flksgrd/IOT_FinalProject/Overleaf/sections/Conclusion.tex

\ifdefined\mainfile\else
\documentclass{article}
\usepackage{graphicx}
\usepackage{float}
\usepackage{amsmath}
\usepackage{amssymb}
\usepackage[a4paper, left=2.5cm, right=2.5cm, top=2.5cm, bottom=2.5cm]{geometry}
\usepackage[colorlinks=true,linkcolor=black,citecolor=blue,urlcolor=blue]{hyperref}

\begin{document}
\fi

\section{Conclusion}
\label{sec:Conclusion}

This project successfully implemented a complete IoT system that fulfills all specified project requirements. WiFi communication, sensing, actuation, and backend visualization were integrated into a working solution. All mandatory deliverables were completed, including demonstration and documentation within the required page limit. A detailed contribution breakdown is provided in the appendix.

\begin{table}[H]
    \centering
    \begin{tabular}{l | c}
       \textbf{Reqierment}  & fufiled \\ \hline
        Use WIFI communication & \checkmark \\
        Minimum 1 Analog sensor, one digital sensor and one form of actuation & \checkmark \\
        Backend/visualization & \checkmark \\
        Poster pitch and demo to the class & \checkmark \\
        Repot max 10 pages & \checkmark
    \end{tabular}
    \caption{Checklist of project reqierments}
    \label{tab:tjeklist}
\end{table}

\end{document}
