flksgrd/IOT_FinalProject/Overleaf/sections/communication-technologies.tex

\ifdefined\mainfile\else
\documentclass{article}
\usepackage{graphicx}
\usepackage{float}
\usepackage{amsmath}
\usepackage{amssymb}
\usepackage[a4paper, left=2.5cm, right=2.5cm, top=2.5cm, bottom=2.5cm]{geometry}
\usepackage[colorlinks=true,linkcolor=black,citecolor=blue,urlcolor=blue]{hyperref}
\begin{document}
\fi

\section{Technical design}
\label{sec:comms}
\subsection{Technical Overview}
The system is built around an ESP8266 microcontroller, which serves as the central control unit for sensing, processing, and communication. The smart bin is equipped with sensors to monitor the fill level of the trash as well as environmental conditions, enabling the system to operate automatically and efficiently.\\
An embedded control system manages the different operational states of the bin, including monitoring, sealing, and standby modes. A full block digram of the system can be seen in Figure \ref{fig:hardware_block_diagram}
\begin{figure}[H]
    \centering
    
    \caption{System Block diagram}
    \label{fig:hardware_block_diagram}
\end{figure}

\subsection{Control System}
The control logic of the system is implemented as a state machine managed by the ESP8266. This approach ensures structured and predictable behavior across different operating conditions.\\
The system operates in four main states: \textit{LOAD}, \textit{CHECK}, \textit{CLOSE}, and \textit{EMPTY\_ME}. Each state defines a specific phase of the system’s operation.\\
In the \textit{LOAD} state, the system waits for the user to position the trash bag and press a button to initialize the process. Once the button is pressed, the system prepares the bag for normal operation and transitions to the next state.\\
In the \textit{CHECK} state, the system periodically measures the fill level of the trash bin at fixed time intervals of 15 minutes. Based on these measurements, the system determines whether the bin has reached a predefined threshold of 8cm or less.\\
When this threshold is reached, the system transitions to the \textit{CLOSE} state. In this state, the closing mechanism is activated to seal the trash bag.\\
After the bag has been sealed, the system transitions to the \textit{EMPTY\_ME} state. In this final state, the system waits for user input before preparing the bin for emptying and resetting the system for the next cycle.
\begin{figure}[H]
\centering
\resizebox{0.7\textwidth}{!}{
\begin{circuitikz}
\tikzstyle{every node}=[font=\fontsize{18.2pt}{23.7pt}\selectfont]

% Definer de 4 states
\draw  (7,25) circle (1.875cm) node[ inner xsep=0.080cm, inner ysep=0.085cm, rounded corners=0.020cm] {\fontsize{19.9pt}{25.9pt}\selectfont Load} ;
\draw  (16,25) circle (1.875cm) node[ inner xsep=0.080cm, inner ysep=0.085cm, rounded corners=0.020cm] {\fontsize{19.9pt}{25.9pt}\selectfont Check} ;
\draw  (16,16) circle (1.875cm) node[ inner xsep=0.080cm, inner ysep=0.085cm, rounded corners=0.020cm] {\fontsize{19.9pt}{25.9pt}\selectfont Close} ;
\draw  (7,16) circle (1.875cm) node[ inner xsep=0.080cm, inner ysep=0.085cm, rounded corners=0.020cm] {\fontsize{19.9pt}{25.9pt}\selectfont EmptyMe} ;

% Pile og betingelser (Transitions)
% Load -> Check
\draw [-{Stealth[scale=1.5]}, ] (8.875,25) -- (14.125,25) 
    node[pos=0.5, fill={rgb,255:red,255; green,255; blue,255}, fill opacity=1, text opacity=1, inner xsep=0.080cm, inner ysep=0.085cm, rounded corners=0.020cm] {Button = HIGH};

% Check -> Close
\draw [-{Stealth[scale=1.5]}, ] (16,23.125) -- (16,17.875) 
    node[pos=0.5, fill={rgb,255:red,255; green,255; blue,255}, fill opacity=1, text opacity=1, inner xsep=0.080cm, inner ysep=0.085cm, rounded corners=0.020cm] {Distance $\le$ 8 cm};

% Close -> EmptyMe
\draw [-{Stealth[scale=1.5]}, ] (14.125,16) -- (8.875,16) 
    node[pos=0.5, fill={rgb,255:red,255; green,255; blue,255}, fill opacity=1, text opacity=1, inner xsep=0.080cm, inner ysep=0.085cm, rounded corners=0.020cm] {Motors done};

% EmptyMe -> Load
\draw [-{Stealth[scale=1.5]}, ] (7,17.875) -- (7,23.125) 
    node[pos=0.5, fill={rgb,255:red,255; green,255; blue,255}, fill opacity=1, text opacity=1, inner xsep=0.080cm, inner ysep=0.085cm, rounded corners=0.020cm] {Button = HIGH};

\end{circuitikz}
}
\caption{State machine diagram for the smart trash bin}
\label{fig:state-diagram}
\end{figure}

\subsection{Mechanical Design}
The mechanical components of the system are based on a custom-designed 3D model of the trash bin.
The closing mechanism works by using two stepper motors to rotate two rollers with three O-rings on each. This mechanism pulls and releases the strings of the trash bag.
When activated, the motors rotate the rollers, and the friction between the O-rings and the strings pulls the strings in and closes the bag. The direction of rotation can also be reversed to loosen the strings when the trash bag needs to be removed.
The design keeps the closing/releasing mechanism compact while still allowing the rollers and motors to be aligned. Furthermore, the custom 3D construction allows for precise tolerances between the rollers and the stepper motors.
The 3D design also features a lid with mounting points and cutouts for attaching the ultrasonic sensor and the button used to control the embedded system. 
Figure \ref{fig:cad_design} shows an exploded view of the 3D CAD model.

\begin{figure}[H]
    \centering
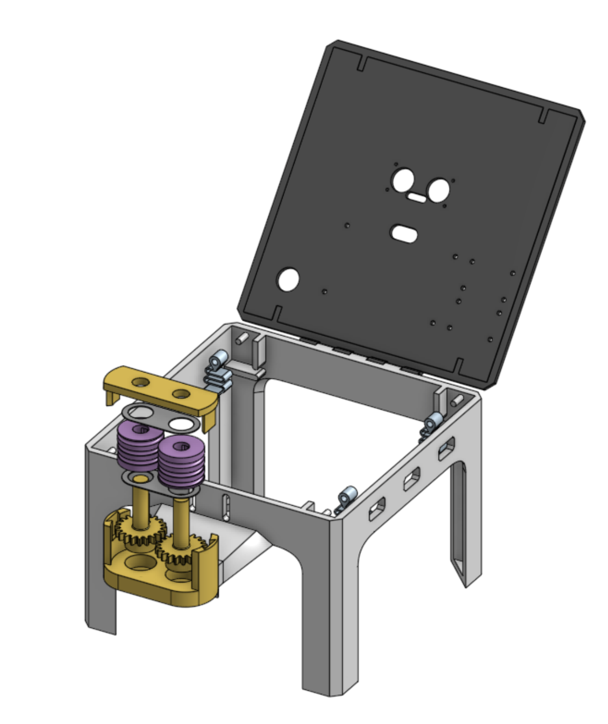
[picture p9: Overleaf/images/screenshots/Cad_model.png]
    
    \caption{3D CAD design of the trash bin}
    \label{fig:cad_design}
\end{figure}

\subsection{Communication and Notifications
}
The ESP connects to the local WiFi network and pushes all its data to ThingSpeak over HTTP. On the notification side we use IFTTT(IF This Then That: two ThingSpeak React rules watch field 4 (bag-full flag) and field 2 (bags remaining) and fire a push notification to the user's phone when the bag is full or when the stock drops below three. Setup is minimal — the user installs the IFTTT app, connects the ThingSpeak service once, and from then on gets notified without having to check the dashboard. It is not a sophisticated solution, but for a prototype it means the bin can actually reach the user when they are in another room

\ifdefined\mainfile\else
\end{document}
\fi
