flksgrd/IOT_FinalProject/Overleaf/sections/data-presentation.tex

\ifdefined\mainfile\else
\documentclass{article}
\usepackage{graphicx}
\usepackage{float}
\usepackage{amsmath}
\usepackage{amssymb}
\usepackage[a4paper, left=2.5cm, right=2.5cm, top=2.5cm, bottom=2.5cm]{geometry}
\usepackage[colorlinks=true,linkcolor=black,citecolor=blue,urlcolor=blue]{hyperref}
\begin{document}
\fi

\section{How we present data to the user}
\label{sec:presentation}

The user sees the bin's status through three surfaces, each chosen for a different context. The primary one is the web dashboard at \url{https://dtutrash.netlify.app/} -- a single page with four large cards (\emph{Bags remaining}, \emph{Distance}, \emph{State} and \emph{Temperature}) that auto-refreshes every 5 seconds, plus an input box for remotely setting the bag inventory. Writing to that input pushes the new count to ThingSpeak field 5; the ESP polls field 5 within 30\,s, copies it into its internal counter, and confirms by writing the value back on field 2, which the dashboard then picks up. Worst-case round-trip is roughly $30 + 16 + 5 = 51$ s, which we communicate to the user with a toast that says \emph{"Set to X bags -- ESP fetches in $<$30\,s"}.
\\ \\
Two small details on the dashboard needed smart ways to do. The first is the ONLINE/OFFLINE pill in the top-right corner: ThingSpeak will happily serve cached data even when the ESP is unplugged, so HTTP success says nothing about whether the bin is alive. The pill instead checks the age of the latest ESP reading and flips to OFFLINE if it is older than 90\,s. 
\\ \\
The second surface is the on-device OLED display. The SSD1306 on the lid shows the current FSM state in plain English (\textsc{Ready}, \textsc{Checking}, \textsc{Closing bag}, \textsc{Replace bag}). It is the channel for moments when the user is standing at the bin and does not want to pull out their phone.
\\ \\
The third surface is push notifications, delivered via IFTTT and triggered by a ThingSpeak React rule: \emph{Trash bag is full -- please replace it} fires on \texttt{field4 = 1}, and \emph{Running low on trash bags} fires on \texttt{field2 $<$ 3}. IFTTT is a good fit for a tinkering project like ours, but a polished product would ship its own app so everything lives in one place.

\ifdefined\mainfile\else
\end{document}
\fi
