flksgrd/IOT_FinalProject/Overleaf/appendix-sections/figures.tex

\ifdefined\mainfile\else
\documentclass{article}
\usepackage{circuitikz}
\usepackage{graphicx}
\usepackage{float}
\usepackage[a4paper, left=2.5cm, right=2.5cm, top=2.5cm, bottom=2.5cm]{geometry}
\usepackage[colorlinks=true,linkcolor=black,citecolor=blue,urlcolor=blue]{hyperref}
\begin{document}
\fi

\section{Larger figures}
\label{sec:appendix-figures}

This appendix reproduces the report's main figures at a larger size for readability, and collects screenshots of the cloud-side configuration so the setup is reproducible.

% ------------------------------------------------------------------
% Helper for "screenshot pending" boxes -- replace each block with
% a real \includegraphics{...} once the screenshot has been added
% to Overleaf/images/screenshots/.
% ------------------------------------------------------------------
\newcommand{\tbdimg}[2]{%
    \fbox{\parbox[c][6cm][c]{0.9\textwidth}{\centering\itshape TODO: add screenshot -- #1\\[2pt]\small(save to \texttt{images/screenshots/#2})}}%
}

\subsection*{Device-side state machine}

\begin{figure}[H]
\centering
\resizebox{1\textwidth}{!}{
\begin{circuitikz}
\tikzstyle{every node}=[font=\fontsize{18.2pt}{23.7pt}\selectfont]

% Definer de 4 states
\draw  (7,25) circle (1.875cm) node[ inner xsep=0.080cm, inner ysep=0.085cm, rounded corners=0.020cm] {\fontsize{19.9pt}{25.9pt}\selectfont Load} ;
\draw  (16,25) circle (1.875cm) node[ inner xsep=0.080cm, inner ysep=0.085cm, rounded corners=0.020cm] {\fontsize{19.9pt}{25.9pt}\selectfont Check} ;
\draw  (16,16) circle (1.875cm) node[ inner xsep=0.080cm, inner ysep=0.085cm, rounded corners=0.020cm] {\fontsize{19.9pt}{25.9pt}\selectfont Close} ;
\draw  (7,16) circle (1.875cm) node[ inner xsep=0.080cm, inner ysep=0.085cm, rounded corners=0.020cm] {\fontsize{19.9pt}{25.9pt}\selectfont EmptyMe} ;

% Pile og betingelser (Transitions)
% Load -> Check
\draw [-{Stealth[scale=1.5]}, ] (8.875,25) -- (14.125,25)
    node[pos=0.5, fill={rgb,255:red,255; green,255; blue,255}, fill opacity=1, text opacity=1, inner xsep=0.080cm, inner ysep=0.085cm, rounded corners=0.020cm] {Button = HIGH};

% Check -> Close
\draw [-{Stealth[scale=1.5]}, ] (16,23.125) -- (16,17.875)
    node[pos=0.5, fill={rgb,255:red,255; green,255; blue,255}, fill opacity=1, text opacity=1, inner xsep=0.080cm, inner ysep=0.085cm, rounded corners=0.020cm] {Distance $\le$ 8 cm};

% Close -> EmptyMe
\draw [-{Stealth[scale=1.5]}, ] (14.125,16) -- (8.875,16)
    node[pos=0.5, fill={rgb,255:red,255; green,255; blue,255}, fill opacity=1, text opacity=1, inner xsep=0.080cm, inner ysep=0.085cm, rounded corners=0.020cm] {Motors done)};

% EmptyMe -> Load
\draw [-{Stealth[scale=1.5]}, ] (7,17.875) -- (7,23.125)
    node[pos=0.5, fill={rgb,255:red,255; green,255; blue,255}, fill opacity=1, text opacity=1, inner xsep=0.080cm, inner ysep=0.085cm, rounded corners=0.020cm] {Button = HIGH};

\end{circuitikz}
}
\caption{State machine diagram for the smart trash can}
\label{fig:state-diagram}
\end{figure}

% ------------------------------------------------------------------
\subsection*{Web dashboard}

\begin{figure}[H]
    \centering
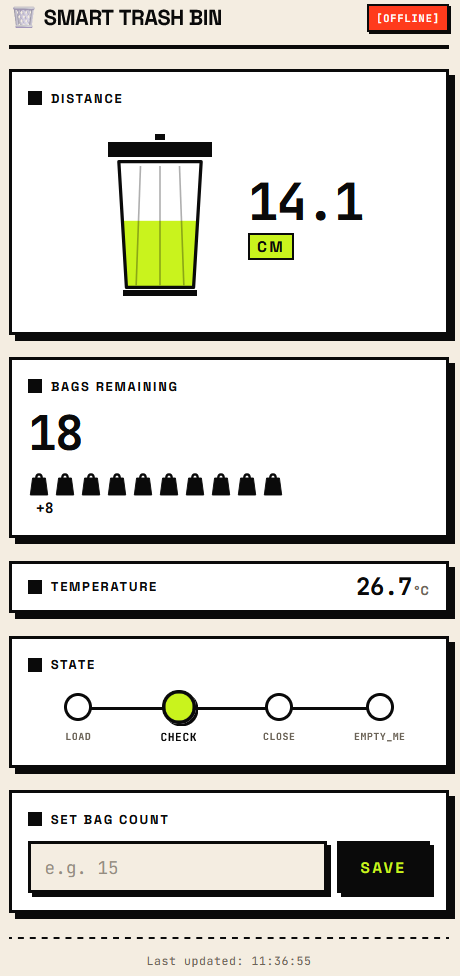
[picture p10: Overleaf/images/screenshots/dashboard_main.png]
    
    \caption{Web dashboard hosted on Netlify -- live view of distance, bags remaining, temperature and FSM state, with the OFFLINE pill in the top-right corner. The "Set bag count" input writes to ThingSpeak field 5, which the ESP picks up on its next 30\,s poll.}
    \label{fig:dashboard-main}
\end{figure}

% ------------------------------------------------------------------
\subsection*{ThingSpeak channel}

\begin{figure}[H]
    \centering
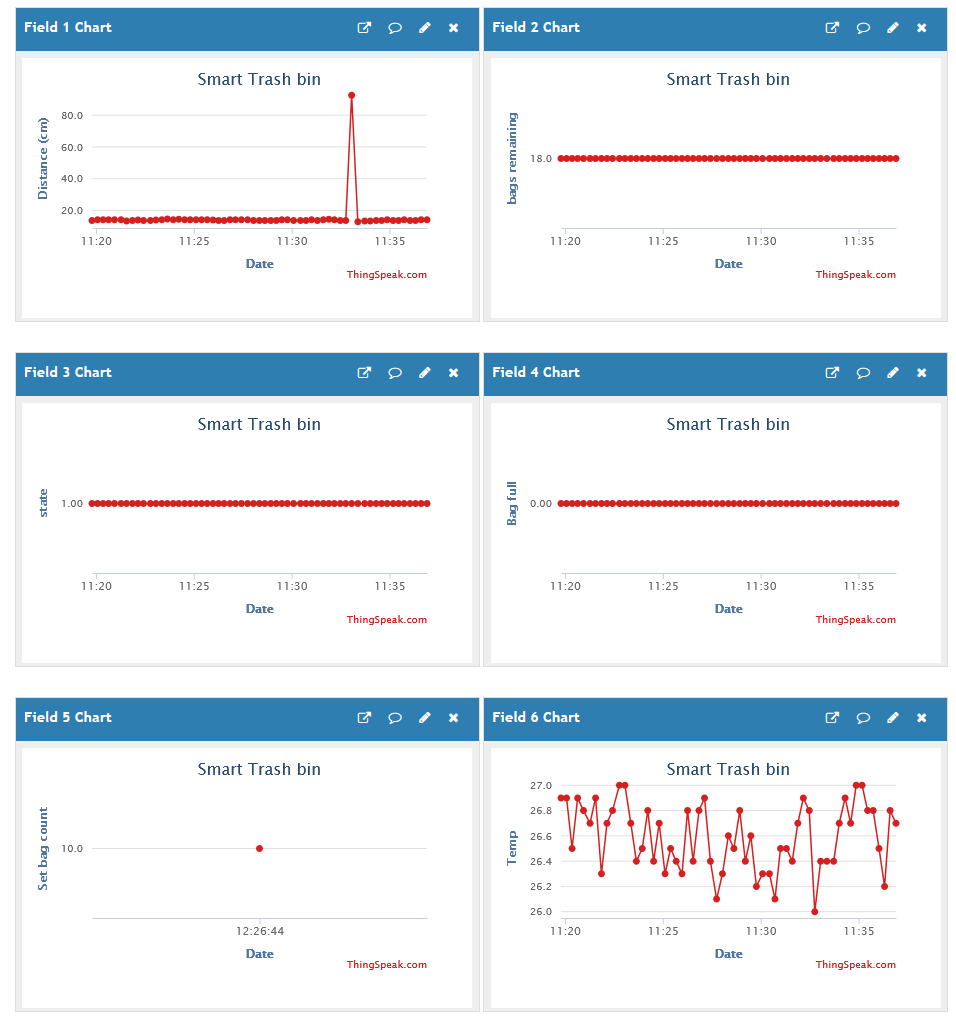
[picture p11: Overleaf/images/screenshots/thingspeak_channel.png]
    
    \caption{ThingSpeak channel 3364403. Field 1 plots distance in cm, field 2 the bag inventory, field 3 the FSM state, field 4 the bag-full event flag, field 5 the dashboard's set-bag-count commands and field 6 the LM35 temperature reading.}
    \label{fig:thingspeak-channel}
\end{figure}

\subsection*{Phone Notifications}

\begin{figure}[H]
    \centering
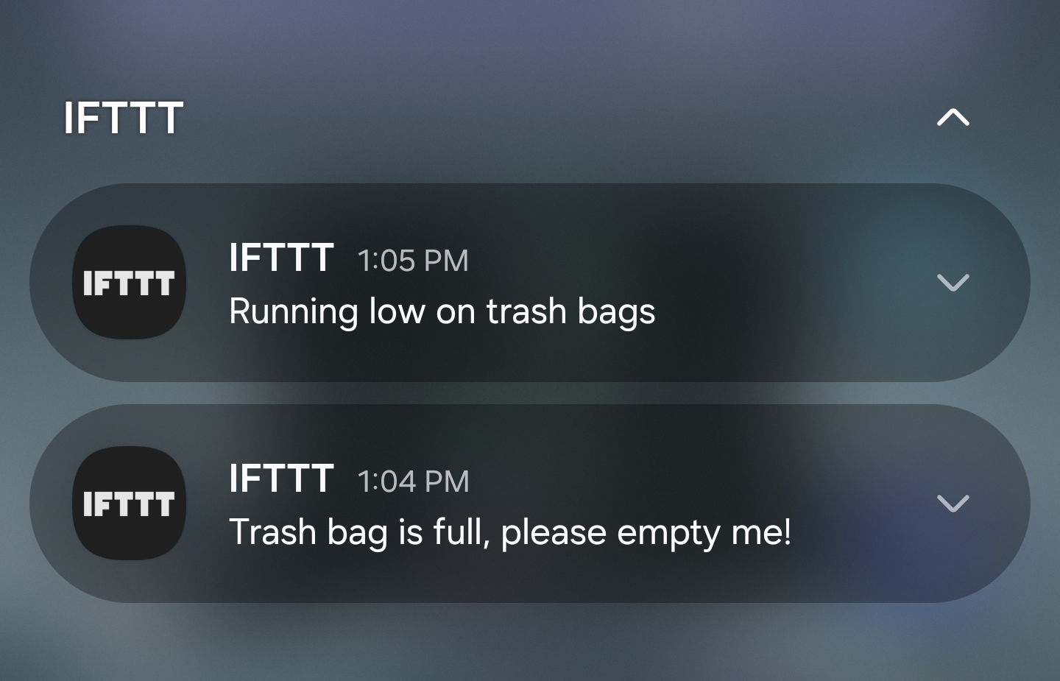
[picture p12: Overleaf/images/screenshots/phone_notification.png]
     
    \caption{Push notification as it arrives on the user's phone (sent by IFTTT in response to a ThingSpeak React rule).}
    \label{fig:phone-notification}
\end{figure}

% ------------------------------------------------------------------
\subsection*{Working prototype}

\begin{figure}[H]
    \centering
    
    \caption{The fully assembled Smart Trash Bin.}
    \label{fig:bin-assembled}
\end{figure}
\ifdefined\mainfile\else
\end{document}
\fi
