flksgrd/IOT_FinalProject/Overleaf/appendix-sections/group-contract.tex

\ifdefined\mainfile\else
\documentclass{article}
\usepackage{graphicx}
\usepackage{float}
\usepackage[a4paper, left=2.5cm, right=2.5cm, top=2.5cm, bottom=2.5cm]{geometry}
\usepackage[colorlinks=true,linkcolor=black,citecolor=blue,urlcolor=blue]{hyperref}
\begin{document}
\fi

\section{Group contract}
\label{sec:appendix-group-contract}

The group contract was filled in and signed by all six members in Session~1 (26 March 2026). The signed document is uploaded to DTU LEARN alongside this appendix as a separate file.

\begin{figure}[H]
    \centering
    
\end{figure}

\begin{figure}[H]
    \centering
    
\end{figure}

\begin{figure}[H]
    \centering
    
\end{figure}

\ifdefined\mainfile\else
\end{document}
\fi
