flksgrd/IOT_FinalProject/Overleaf/appendix-sections/who-did-what.tex

\ifdefined\mainfile\else
\documentclass{article}
\usepackage{graphicx}
\usepackage{float}
\usepackage[a4paper, left=2.5cm, right=2.5cm, top=2.5cm, bottom=2.5cm]{geometry}
\usepackage[colorlinks=true,linkcolor=black,citecolor=blue,urlcolor=blue]{hyperref}
\begin{document}
\fi

\section{Who did what}
\label{sec:appendix-who}

The table below summarises module ownership during the project. The "share" column gives an approximate percentage distribution of effort per group member across the project as a whole, estimated jointly by the group at the end of the project. The total sums to 100\%.

\begin{table}[H]
    \centering
    \begin{tabular}{l|l|l}
        \textbf{Module} & \textbf{Owner(s)} & \textbf{Notes} \\
        \hline
        Mechanical / CAD design                  & Sigurd, Tobias, Anders              & 3D-printed prototypes \\
        
        Motor + sensor integration               & Jonas, Tobias, Andreas, Sigurd      & ULN2003, HC-SR04 \\
        Firmware (state machine, ESP8266)        & Mads, Tobias, Andreas, Jonas                        & \texttt{sketch\_apr16a.ino} \\
        ThingSpeak + IFTTT integration           & Mads, Sigurd                        & React rules, applets \\
        Web dashboard                            & Mads, Sigurd                      & \texttt{docs/index.html} \\
        OLED + LM35 (display, temperature)       & Anders, Tobias, Andreas, Jonas                      & SSD1306 I\textsuperscript{2}C, IIR filter \\
        Report                                   & All                         & \\
    \end{tabular}
    \caption{Module ownership}
    \label{tab:modulansvar}
\end{table}

\begin{table}[H]
    \centering
    \begin{tabular}{l|c|c}
        \textbf{Name} & \textbf{Student no.} & \textbf{Share of effort} \\
        \hline
        Anders Falkesgaard            & s245905 & 17\% \\
        Andreas Jacobsen              & s241123 & 17\% \\
        Jonas Beck Jensen             & s240324 & 16\% \\
        Mads Rudolph                  & s246132 & 17\% \\
        Sigurd Hestbech Christiansen  & s245534 & 17\% \\
        Tobias Nilsson                & s233987 & 16\% \\
        \hline
        \textbf{Total}                &         & \textbf{100\%}\\
    \end{tabular}
    \caption{Approximate percentage distribution of effort per group member}
    \label{tab:tidsforbrug}
\end{table}

\ifdefined\mainfile\else
\end{document}
\fi
