flksgrd/IOT_FinalProject/MATLAB/battery_life.png

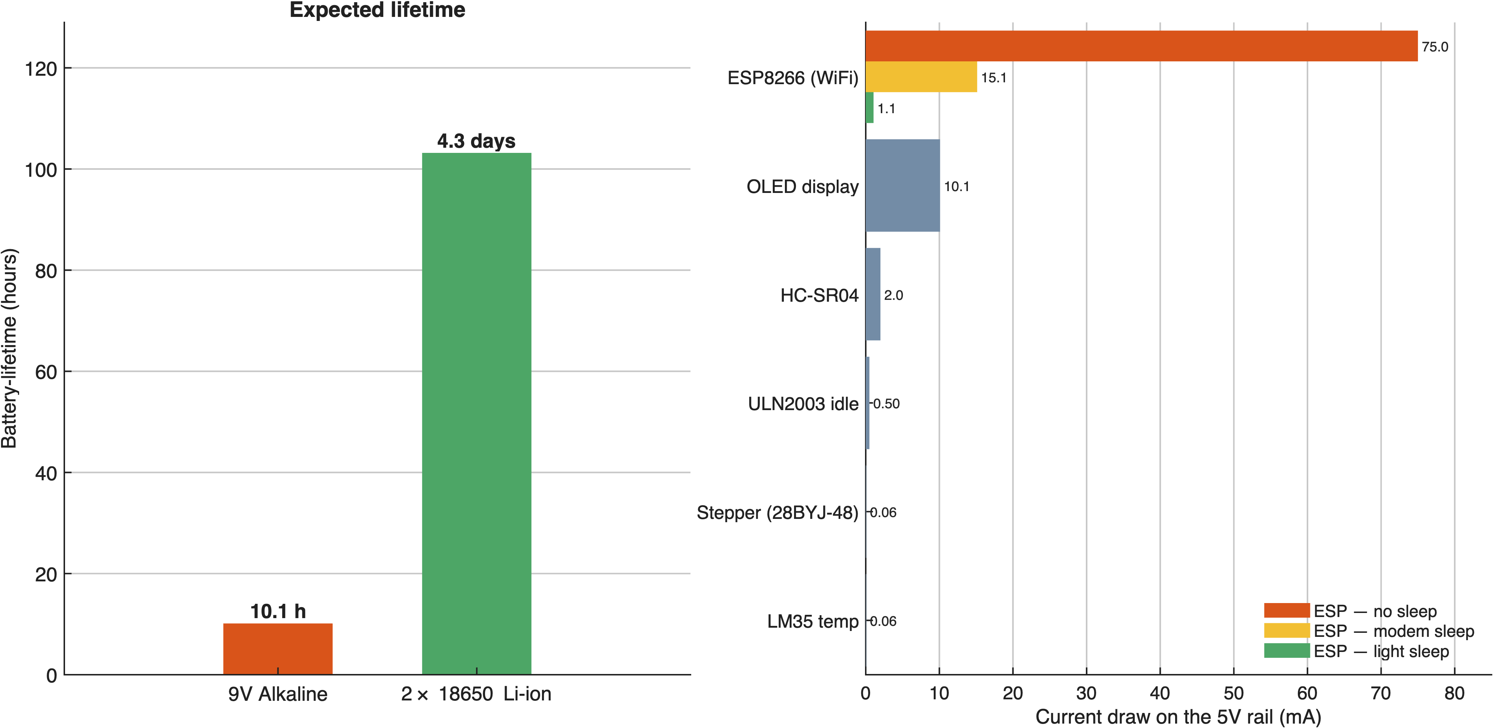
MATLAB/battery_life.png
