flksgrd/IOT_FinalProject/MATLAB/whatif_deepsleep.png

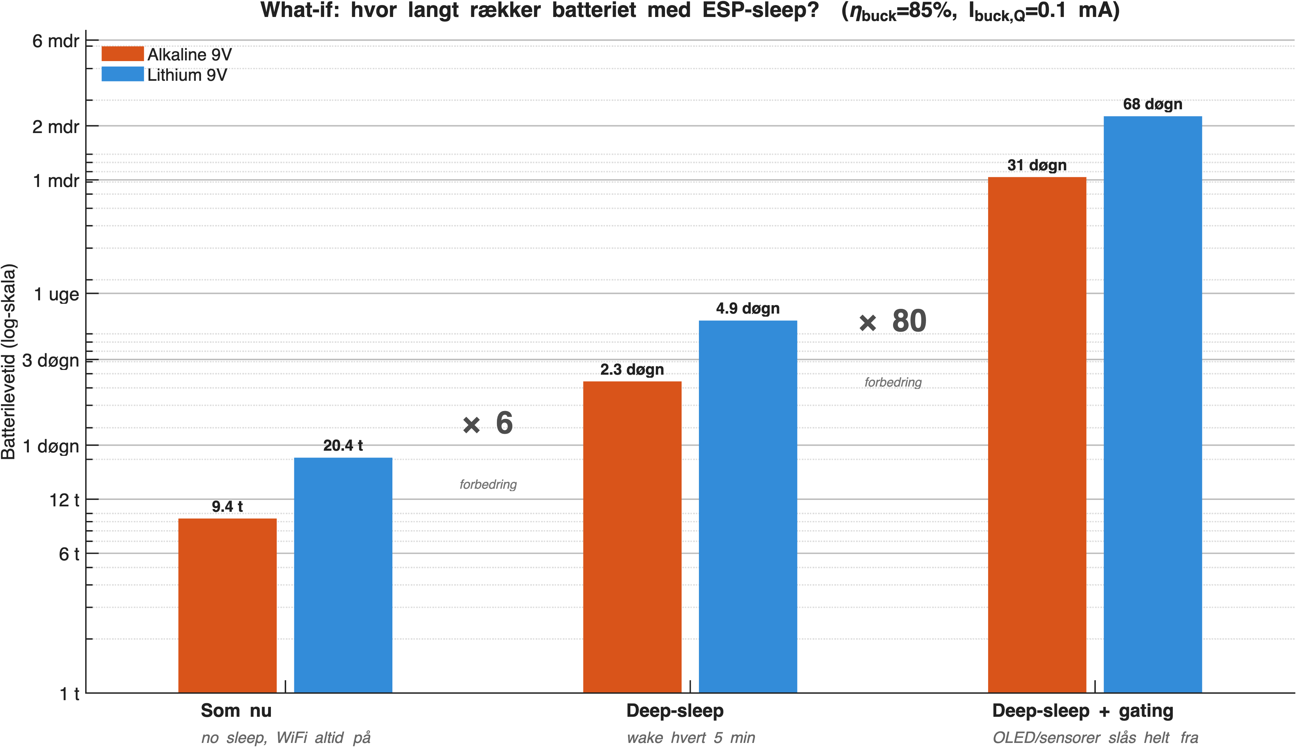
MATLAB/whatif_deepsleep.png
