flksgrd/IOT_FinalProject/MATLAB/whatif_sleepmodes.png

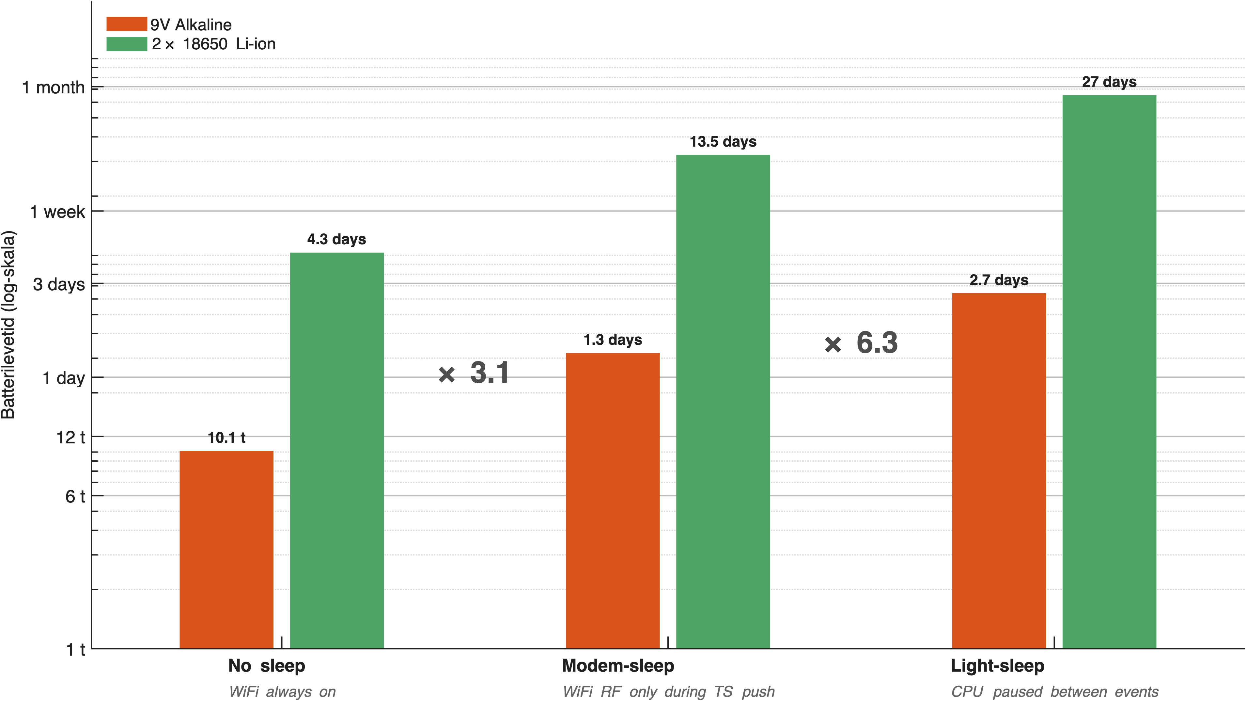
MATLAB/whatif_sleepmodes.png
