flksgrd/IOT_FinalProject/Overleaf/images/system/state_diagram.png

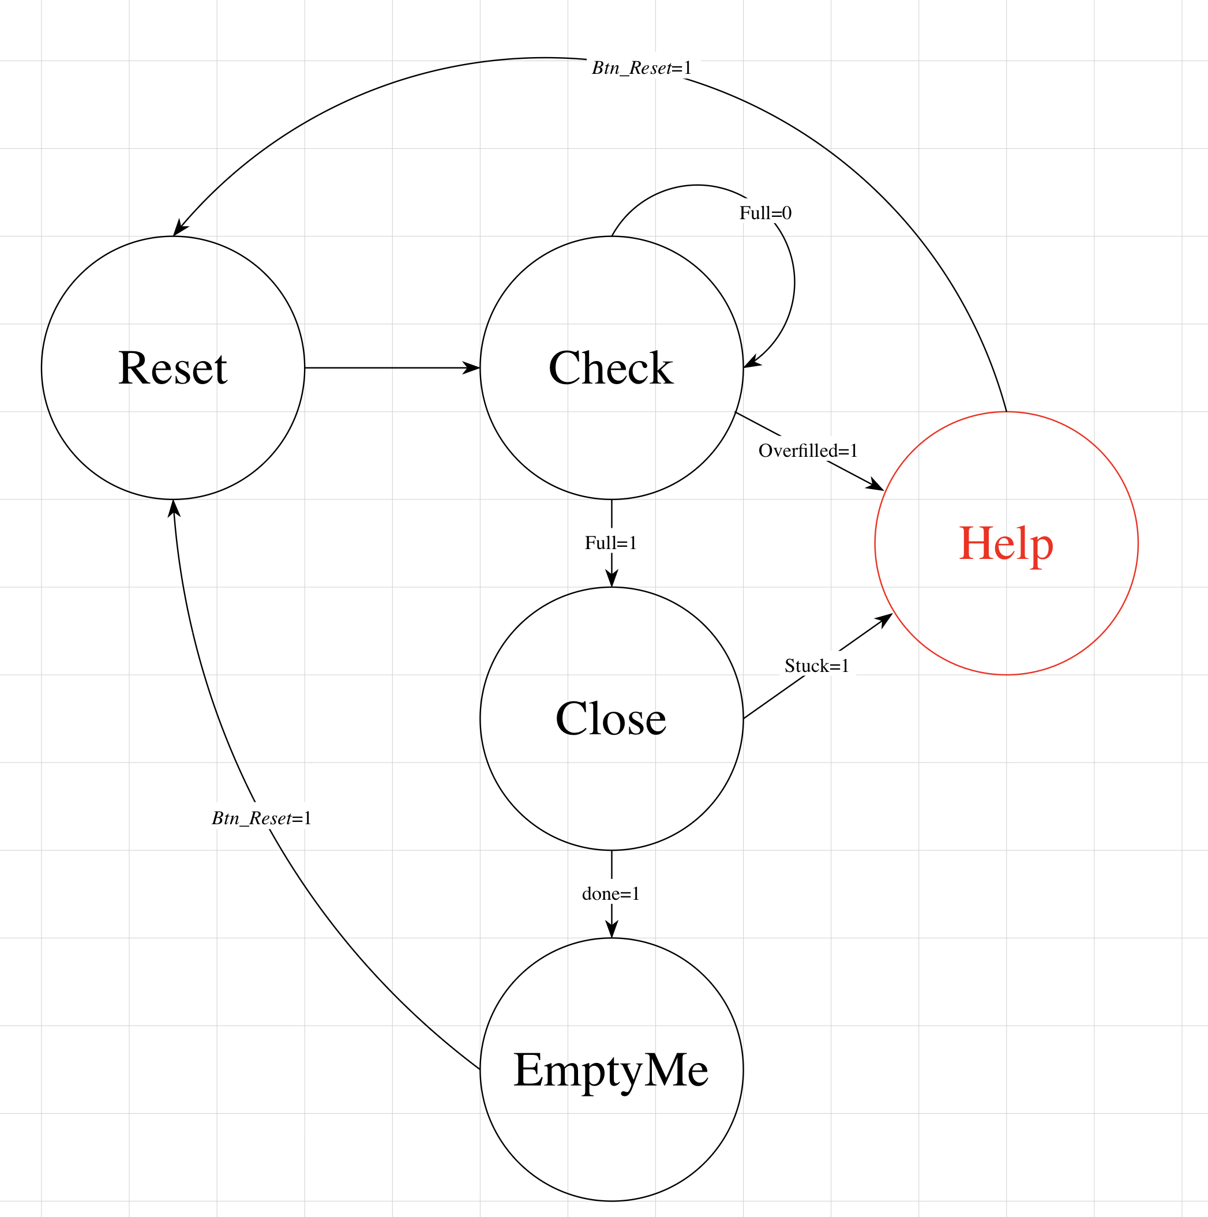
Overleaf/images/system/state_diagram.png
