flksgrd/IOT_FinalProject/Report/images/system/Hardware_block_diagram.png

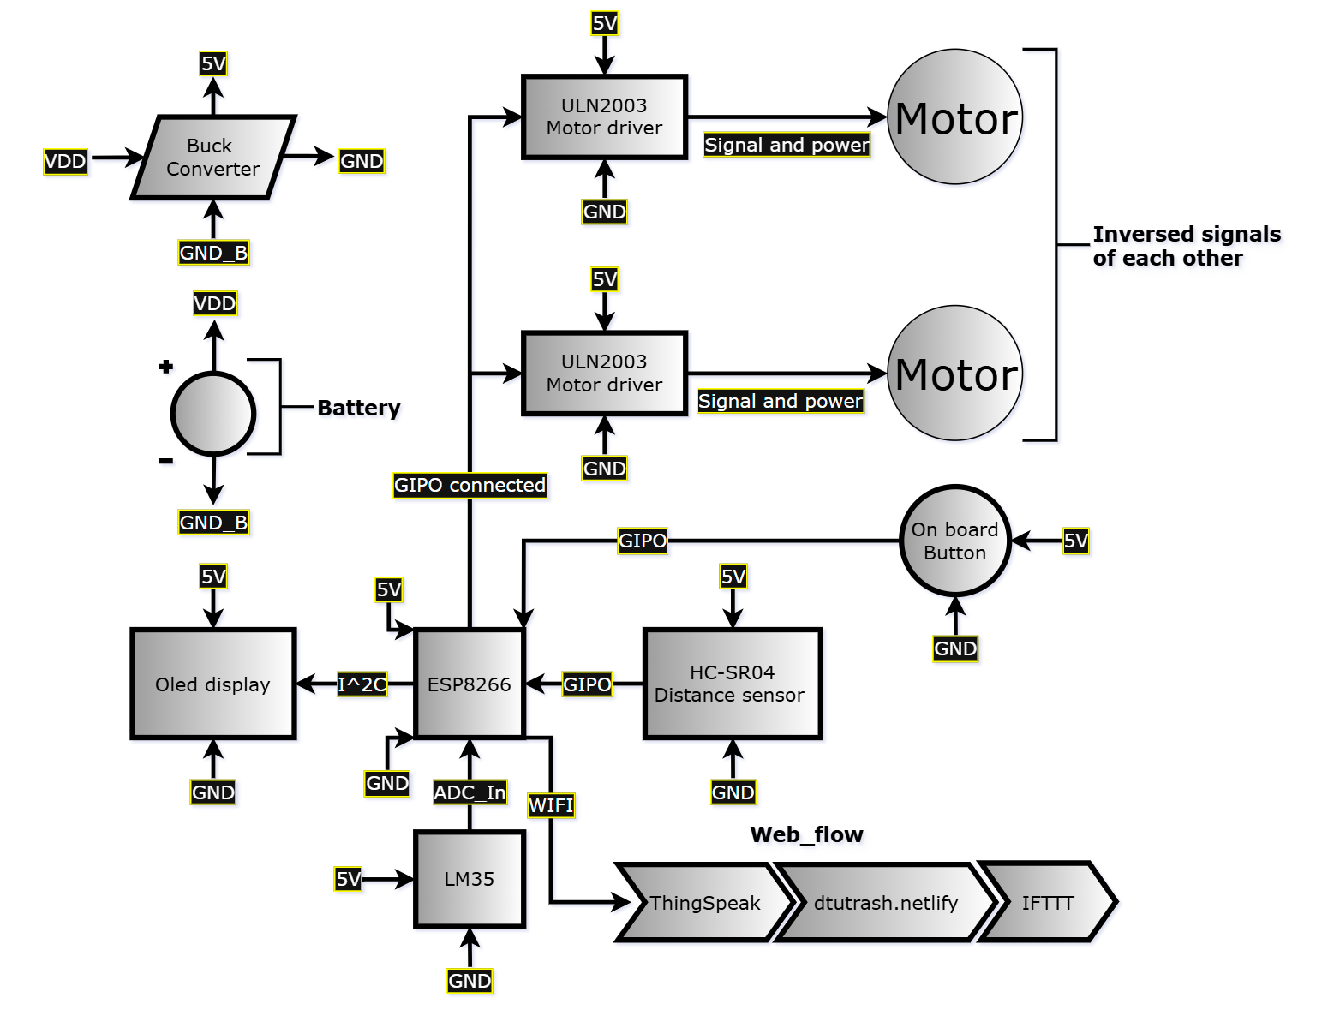
Report/images/system/Hardware_block_diagram.png
