flksgrd/IOT_FinalProject/Report/images/Underskreven Gruppekontrakt.png

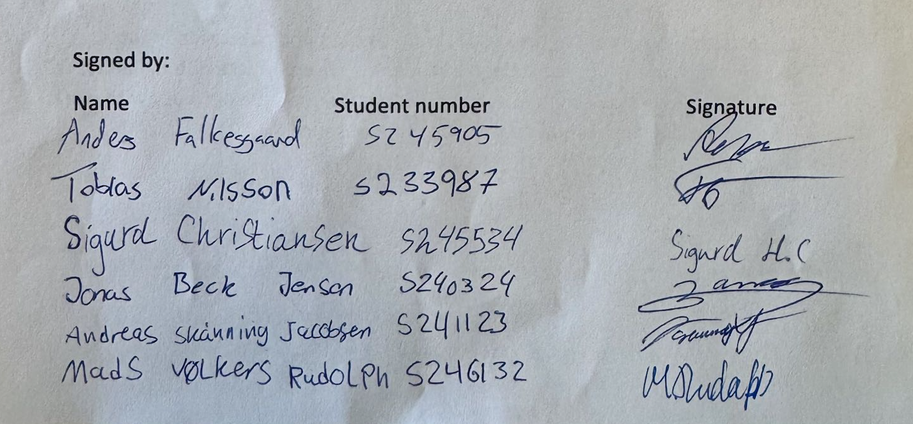
Report/images/Underskreven Gruppekontrakt.png
