flksgrd/IOT_FinalProject/Overleaf/appendix-sections/self-evaluation.tex

\ifdefined\mainfile\else
\documentclass{article}
\usepackage{graphicx}
\usepackage{float}
\usepackage[a4paper, left=2.5cm, right=2.5cm, top=2.5cm, bottom=2.5cm]{geometry}
\usepackage[colorlinks=true,linkcolor=black,citecolor=blue,urlcolor=blue]{hyperref}
\begin{document}
\fi

\section{Self-evaluation}
\label{sec:appendix-self-eval}

\subsection*{Group self-evaluation}

The completed group self-evaluation form is uploaded to DTU LEARN as a separate file.

% TODO: paste the agreed-on group self-evaluation text here, or
% replace with \includepdf{...} pointing to the filled-in form
% before submission.

\subsection*{Individual self-evaluations}

Each group member has completed an individual self-evaluation form. These are uploaded to DTU LEARN, one per student, as separate files.

% TODO: either inline each individual self-evaluation here, or
% \includepdf{...} each one before submission.

\ifdefined\mainfile\else
\end{document}
\fi
