flksgrd/IOT_FinalProject/Log book/Session 10.md

#### Date: 04/05/2026

| Name | Study Number | Present | Absent | Note | Signature |
| --- | :---: | :-----: | :----: | :--: | --- |
| Jonas Jensen | s240324 | x | | | |
| Andreas Jacobsen | s241123 | x | | | |
| Sigurd Hestbech | s245534 | | x | Work | |
| Tobias Nilsson | s233987 | x | | | |
| Mads Rudolph | s246132 | x | | | |
| Anders Falkesgaard | s245905 | x | | | |
#### Task carried out during the session:
- Jonas and Andreas is working on optimizing the code. 
  The light-sleep mode had a conflict with the I2C during startup of the chip. So we discussed depending on Modem Sleep only, but ultimately agreed on trying to get the light-sleep to work. Which they succeded with (Boot order).
- Anders began the power calculations. 
- We continued setting up the poster. The photo has been scrapped (The prototype will stand next to the poster). Made space for the PCB-schematic as well. Began designing the space for the power calculations in the middle of the poster.
- Built and deployed a small web dashboard at https://dtutrash.netlify.app/ for viewing live bag count, distance and state, with an input field to set the bag count remotely.
- Tobias made final revisions on v2 of the PCB and began the printing, it should be done tomorrow.
- Sometimes the bag strings are getting caught up in the gears, Sigurd designed some spacers to prevent that from home.
