flksgrd/IOT_FinalProject/Log book/Session 11.md

#### Date: 05/05/2026

| Name | Study Number | Present | Absent | Note | Signature |
| --- | :---: | :-----: | :----: | :--: | --- |
| Jonas Jensen | s240324 | x | | | |
| Andreas Jacobsen | s241123 | x | | | |
| Sigurd Hestbech | s245534 | x | | | |
| Tobias Nilsson | s233987 | x | | | |
| Mads Rudolph | s246132 | x | | | |
| Anders Falkesgaard | s245905 | x | | | |
#### Task carried out during the session:
- Even with the spacers, the trash can still has problems closing reliably, Sigurd has made room for more O-rings on the wheels, we will print and test tomorrow. Hopefully final revision.
- Anders finalized the power calculations
- Andreas, Jonas, Sigurd, Tobias was combining the final parts (minus the new wheels) and mounted the PCB to the trash can. (The lid is opening the wrong way, but we determined that it was a minor problem easily explained at the poster presentation.)
- Spent the rest of the day testing the trash can and found a loose VCC wire to one of the motor drivers, which means that one motor should have to drive both motors + the wheels and bag. Tobias found and fixed the problem, but we will implement the new wheels as well tomorrow.
- Mads designed a flow-diagram for the Thingspeak part of the poster
