flksgrd/IOT_FinalProject/Log book/Session 4.md

#### Date: 23/04/2026

| Name | Study Number | Present | Absent | Note | Signature |
| --- | :---: | :-----: | :----: | :--: | --- |
| Jonas Jensen | s240324 | x | | | |
| Andreas Jacobsen | s241123 | x | | | |
| Sigurd Hestbech | s245534 | x | | | |
| Tobias Nilsson | s233987 | x | | | |
| Mads Rudolph | s246132 | | x | Sick | |
| Anders Falkesgaard | s245905 | x | | | |
#### Task carried out during the session:
- Sigurd continues with CAD and makes adjustments based on our learnings with the first prototype.
- Jonas, Tobias and Andreas is beginning to implement the different motor options into the first prototype, and test with the draft of our code.
- Anders have created and begun writing an Overleaf document for the report as well as streamlining the log book proces.
