flksgrd/IOT_FinalProject/Log book/Session 8.md

#### Date: 02/05/2026

| Name | Study Number | Present | Absent | Note | Signature |
| --- | :---: | :-----: | :----: | :--: | --- |
| Jonas Jensen | s240324 | x | | | |
| Andreas Jacobsen | s241123 | x | | | |
| Sigurd Hestbech | s245534 | x | | | |
| Tobias Nilsson | s233987 | x | | | |
| Mads Rudolph | s246132 | x | | | |
| Anders Falkesgaard | s245905 | x | | | |
#### Task carried out during the session:
- The bag is not closing reliably, so we will install a second motor. We will therefore go from a single-motor design to a dual-motor setup.
- Sigurd Is redesigning the gears and housing to make space for the extra motor, Anders will print it before next session (tomorrow)
- Anders, Jonas and Andreas added an SSD1306 OLED display and a temperature sensor to the bin. Started with a DHT11 (temp + humidity) but switched to a simpler LM35 (temperature only), mainly due to the requirement for an analog sensor. 
- Mads updated the ThingSpeak push to send the value on Field 6.
