flksgrd/IOT_FinalProject/Log book/Session 5.md

#### Date: 30/04/2026

| Name | Study Number | Present | Absent | Note | Signature |
| --- | :---: | :-----: | :----: | :--: | --- |
| Jonas Jensen | s240324 | x | | | |
| Andreas Jacobsen | s241123 | x | | | |
| Sigurd Hestbech | s245534 | x | | | |
| Tobias Nilsson | s233987 | x | | | |
| Mads Rudolph | s246132 | x | | | |
| Anders Falkesgaard | s245905 | x | | | |
#### Task carried out during the session:
- Mads integrated ThingSpeak and IFTTT into the firmware: the bin now pushes bag count, distance, state and bag-full events to the cloud, and reads bag-count updates from the phone via Field 5.
- Set up the ThingSpeak channel with ThingHTTP entries and React rules so a "bag full" or "low bags" event triggers a push notification on the phone via IFTTT.
- Built and deployed a small web dashboard at https://dtutrash.netlify.app/ for viewing live bag count, distance and state, with an input field to set the bag count remotely.
- Updated the README to reflect the current IoT pipeline and the new dashboard.
- Jonas and Andreas worked on optimizing the firmware (light-sleep mode for the WiFi, adjusted stepper distance, code cleanup) and troubleshooting the closing mechanism, going from a single-motor design to a dual-motor setup.
- Added a MOSFET on the stepper-driver power line to make it more efficient and reduce idle current.

#### Task to be done before next week:
