flksgrd/IOT_FinalProject/Log book/Session 3.md

#### Date: 16/04/2026

| Name | Study Number | Present | Absent | Note | Signature |
| --- | :---: | :-----: | :----: | :--: | --- |
| Jonas Jensen | s240324 | x | | | |
| Andreas Jacobsen | s241123 | | x | Sick | |
| Sigurd Hestbech | s245534 | x | | | |
| Tobias Nilsson | s233987 | x | | | |
| Mads Rudolph | s246132 | x | | | |
| Anders Falkesgaard | s245905 | x | | | |
#### Task carried out during the session:
- Sigurd and Anders began designing the mechanism in CAD
- Jonas and Tobias began to examine and test different motor options and their compatibility with the sensors at our disposal.
- Mads began to design our code. 
- Anders created a state diagram.

#### Task to be done before next week:
- *Sigurd*
  Sigurd will continue to think of ideas and maybe implement into the next prototype. 
- *Anders* 
  Print the first prototype before next weeks session.
