flksgrd/IOT_FinalProject/Overleaf/appendix-sections/log-book.tex

\ifdefined\mainfile\else
\documentclass{article}
\usepackage{graphicx}
\usepackage{float}
\usepackage{pdfpages}
\usepackage{array}
\usepackage{longtable}
\usepackage[a4paper, left=2.5cm, right=2.5cm, top=2.5cm, bottom=2.5cm]{geometry}
\usepackage[colorlinks=true,linkcolor=black,citecolor=blue,urlcolor=blue]{hyperref}
\begin{document}
\fi

\section{Log book}
\label{sec:appendix-logbook}

\includepdf[pages={1-},scale=0.9]{Log book/Log_Book_Samlet.pdf}

\ifdefined\mainfile\else
\end{document}
\fi
