flksgrd/IOT_FinalProject/Log book/Session 13.md

#### Date: 12/05/2026

| Name | Study Number | Present | Absent | Note | Signature |
| --- | :---: | :-----: | :----: | :--: | --- |
| Jonas Jensen | s240324 | x | | | |
| Andreas Jacobsen | s241123 | x | | | |
| Sigurd Hestbech | s245534 | x | | | |
| Tobias Nilsson | s233987 | x | | | |
| Mads Rudolph | s246132 | x | | | |
| Anders Falkesgaard | s245905 | x | | | |
#### Task carried out during the session:
- Everyone has filled out parts of the report from home individually. today we meet up to combine and agree on the final report.
- We filled out the group evaluation at the end of the day
