flksgrd/IOT_FinalProject/Log book/Session 2.md

#### Date: 09/04/2026

| Name | Study Number | Present | Absent | Note | Signature |
| --- | :---: | :-----: | :----: | :--: | --- |
| Jonas Jensen | s240324 | x | | | |
| Andreas Jacobsen | s241123 | x | | | |
| Sigurd Hestbech | s245534 | | x | Sick | |
| Tobias Nilsson | s233987 | x | | | |
| Mads Rudolph | s246132 | x | | | |
| Anders Falkesgaard | s245905 | | x | Sick | |
#### Task carried out during the session:
- Github created 
- Discussion and final decision to go with the trash can project.
- Further brainstorming about the general design choice (Which type of bags, size, mechanism options, etc.)
