flksgrd/IOT_FinalProject/Log book/Session 12.md

#### Date: 06/05/2026

| Name | Study Number | Present | Absent | Note | Signature |
| --- | :---: | :-----: | :----: | :--: | --- |
| Jonas Jensen | s240324 | x | | | |
| Andreas Jacobsen | s241123 | x | | | |
| Sigurd Hestbech | s245534 | x | | | |
| Tobias Nilsson | s233987 | x | | | |
| Mads Rudolph | s246132 | x | | | |
| Anders Falkesgaard | s245905 | x | | | |
#### Task carried out during the session:
- Final assembly, everything works as intended.
- Anders made final touches on the poster + print at Lyngby after lecture
- We made a video on the final product 
- All practiced the poster presentation in front of each other
