flksgrd/IOT_FinalProject/Log book/Session 5 (Spontaneous).md

#### Date: 26/04/2026

| Name | Study Number | Present | Absent | Note | Signature |
| --- | :---: | :-----: | :----: | :--: | --- |
| Jonas Jensen | s240324 | x | | | |
| Andreas Jacobsen | s241123 | x | | | |
| Sigurd Hestbech | s245534 | x | | | |
| Tobias Nilsson | s233987 | | x | | |
| Mads Rudolph | s246132 | | x | | |
| Anders Falkesgaard | s245905 | | x | | |

Jonas, Andreas and Sigurd met up spontaneously
#### Task carried out during the session:
Jonas, Andreas and Sigurd implemented the state machine and made some new CAD-revisions.
