flksgrd/IOT_FinalProject/Log book/Session 1.md

#### Date: 26/03/2026

| Name | Study Number | Present | Absent | Note | Signature |
| --- | :---: | :-----: | :----: | :--: | --- |
| Jonas Jensen | s240324 | x | | | |
| Andreas Jacobsen | s241123 | x | | | |
| Sigurd Hestbech | s245534 | x | | | |
| Tobias Nilsson | s233987 | x | | | |
| Mads Rudolph | s246132 | x | | | |
| Anders Falkesgaard | s245905 | x | | | |
#### Task carried out during the session:
- *Brainstorming ideas* 
  We are pretty sure we will go with a smart thrash can that automatically seals and notifies the user. 
- *Group Contract*
  Read and signed by each member
- *Group Discord created*

#### Task to be done before next week:
- *Easter holiday*
- We will each think about possible challenges and design choices before next time
- Fill out and submit our project description (Andreas is lead, but we will coordinate through discord)
