flksgrd/IOT_FinalProject/FinalProject_Learn/34315 Log book.docx

34315 – Log book

Date:

Members present:

Members absent:

Task carried out during the session:

Tasks to be done for next week incl. responsibles:

Signed by:

Name Student number Signature
