flksgrd/IOT_FinalProject/Poster/Poster_IOT (84.1 x 118.9 cm)-2.pdf

# Automatic waste bin

# Final Project - Group 16

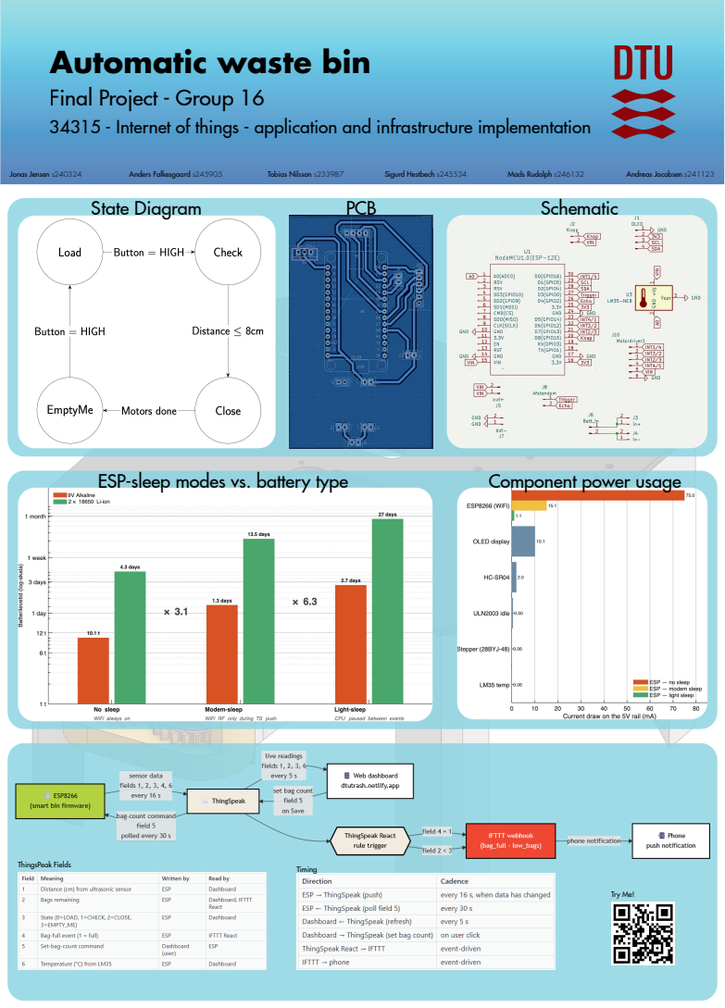
[picture p20: page 1]
State Diagram; Jonas Jensen s240324; Anders Falkesgaard s245905; Tobias Nilsson s233987; Sigurd Hestbech s245534; Mads Rudolph s246132; Andreas Jacobsen s241123; ThingsPeak Fields; Timing; Try Me!; ESP-sleep modes vs. battery type; Component power usage; PCB; Schematic

34315 - Internet of things - application and infrastructure implementation
