flksgrd/IOT_FinalProject/(commit log)

2026-04-26 Motor styring only
2026-04-29 virkende kode til stepper med load og luk
2026-04-29 Udkast af mulig brug af lysssensor og interrupt på åbning af skab
2026-04-30 Tilføjet ThingSpeak integration
    - WiFi forbindelse ved boot
    - Push af afstand, antal poser, state og bag-full event til ThingSpeak
    - Læser Field5 så antal poser kan sættes fjernt fra telefon
    - Bag-full event trigger IFTTT notifikation via ThingSpeak React + ThingHTTP
    - Posetæller decrementeres når ny pose isættes (EMPTY_ME->LOAD)
    - Throttle: push hver 16s, read hver 30s (free tier kræver min 15s)
2026-04-30 sleep og ændrede motorværdier
2026-04-30 Tilføjet web dashboard + WiFi/push robusthed
    - docs/index.html: dashboard til at se og sætte antal poser fra telefon
    via ThingSpeak API. Hostet på https://dtutrash.netlify.app/
    - WiFi.setAutoReconnect(true) så ESP genopretter forbindelse uden reboot
    - tsPush springer Field1 over indtil første reelle ultralydsmåling
    [sketch_apr16a.ino]
2026-04-30 2 motorer + mosfet
2026-05-01 Tilføjet ssd1306 display + temp og hum sensor ^^
2026-05-02 Ændret fra DHT til LM35 sensor, nu kun temp
2026-05-03 Redesign dashboard with industrial-brutalist aesthetic
    Replaces the generic dark/slate theme with a high-contrast cream + ink
    palette and a hi-vis safety accent for screenshots that pop on print.
    - Adds Space Grotesk + JetBrains Mono via Google Fonts
    - Bin SVG with live fill level computed from distance (BIN_DEPTH_CM=30)
    switches to hazard stripes at >=80% full
    - Bag count shown with 10-icon depletion row + overflow chip; hazard
    stripe top + LAV chip when low (<=3)
    - State machine rendered as a 4-node flow with active dot highlighted;
    EMPTY_ME pulses in alert color
    - Online/offline pill driven by fetch success
    - Heavy 3px borders + hard offset shadows throughout
    - All ThingSpeak const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
2026-05-03 Translate dashboard UI from Danish to English
    All visible labels, button text, toast messages, footer states and the
    'LAV' chip are now English. Locale for the timestamp switched from
    da-DK to en-GB (still 24-hour HH:MM:SS). lang attribute updated.
2026-05-03 Flip status pill to OFFLINE when last reading is stale
    ThingSpeak keeps serving cached data when the ESP is powered off,
    so the pill stayed ONLINE despite a dead device. Now we check the
    age of created_at against a 90 s threshold (~3x the ESP's update
    cycle). Empty-feed case also marked OFFLINE.
2026-05-03 Add explainer doc for the web dashboard ↔ ThingSpeak ↔ ESP flow
    Markdown doc for the Obsidian vault explaining how the static HTML
    dashboard, ThingSpeak, and the ESP sketch fit together — written for an
    EE audience (no web-dev background assumed). Uses Obsidian callouts to
    highlight the mental model, the API key locations, the worst-case
    round-trip timing, and the two non-obvious dashboard quirks
    (filtering dashboard-only writes and the staleness-based ONLINE pill).
2026-05-04 Add temperature card with vertical thermometer SVG
    - New card between Bags and State, matching the bin-card visual
    language: SVG sensor silhouette + big mono mono number + unit chip
    - Thermometer SVG with bulb + tube + tick marks (0/10/20/30/40/50 C);
    mercury fill height scales linearly with field6 over 0-50 C
    - 'hot' class on card (>=30 C) flips both mercury and the C unit chip
    to alert red, mirroring how the bin's cm chip flips when full
    - Smooth y/height transition on the mercury rect for live updates
    - Removed broken document.getElementById('hum') line that was throwing
    every refresh because no #hum element existed in markup
2026-05-04 Make temperature card minimalistic
    Drops the thermometer SVG and the chunky number+chip layout in favour
    of a single thin row: 'Temperature' label on the left, 'NN.N °C' on the
    right. Card height is now ~50 px instead of ~200 px. Above 30 C the
    number turns alert red; otherwise no decoration.
2026-05-04 IIR filter added
2026-05-04 Update sketch_apr16a.ino
    %-fuld og digital mosfet
2026-05-06 Udfyldt Session 6 med opgaver siden sidste session
    OLED + LM35 sensor, pinout fix, IIR filter, fjernet MOSFET,
    dashboard-redesign og forklaringsdokument.
2026-05-06 Tilføjet mermaid-diagram over IoT-flow
    Viser dataflowet mellem ESP, ThingSpeak, web dashboard og IFTTT
    inkl. felt-mapping og timing.
2026-05-12 Flatten brief sections: drop nested subsections, remove repetition
    - Hardware design: 4 subsections -> 0 (Microcontroller / Component
    list / Pinout / Mechanical all flow as one section).
    - Communication technologies: 3 subsections -> 0.
    - Software design: 4 subsections -> 0; dashboard description moved
    out of here and kept only in 'data-presentation' to remove overlap.
    - Data presentation: 3 subsections -> 0.
    - Testing and results: 5 subsections -> 0 (component / firmware /
    e2e / weaknesses / future all flow as one section).
    - Reflection: 4 subsections -> 0; problems and fixes paired in
    one bullet list; redundant 'Who did what' pointer dropped (the
    appendix already covers it).
2026-05-12 Samle Datasheets, Log Book updated, Matlab (power calc)
2026-05-13 Fill in the IoT/internet paragraph in software-design
    Replace the MADS SKRIV LIGE... placeholder with a short paragraph
    on how the firmware connects to WiFi, talks to ThingSpeak over
    HTTP as a pure client, and combine it with the existing 'pair of
    non-blocking timers' line so the two flow as one paragraph.
2026-05-13 Expand the IoT paragraph: describe the dirty-flag + throttle + field 5 poll
2026-05-16 Add power-budget paragraph, clean Arduino comments, fill self-evaluations
    - Hardware design: short power-budget paragraph summarising the MATLAB
    battery-life analysis (qualitative, no figure)
    - sketch_apr16a.ino / Temp_ref.ino: comments to short English, fix
    broken/typo comments, keep the non-obvious WHY notes, code unchanged
    - Self evaluation 34315_Anders.docx: draft "General comments about my
    work", complete the cut-off sentence, fix "Higlights" typo
    - Selfevaluation_group.docx: fill the report-content table (12 Good,
    3 Excellent) and the "General comments about the report" field
    [Temp_ref.ino, sketch_apr16a.ino]
2026-05-17 Reflection: correct closure problem -- it was a torque issue, not bag twisting
2026-05-17 Fill power-budget formula placeholder with the symbolic chain
    Replace the empty $$Total_{Power}=$$ slot in hardware-design.tex with the
    symbolic formulas used in MATLAB/BatteryLife.m (weighted average current,
    rail power, battery-side draw, battery life) plus a short symbol legend.
    Symbolic only, no numeric values.
