flksgrd/IOT_FinalProject/Overleaf/images/screenshots/bin_assembled.jpg

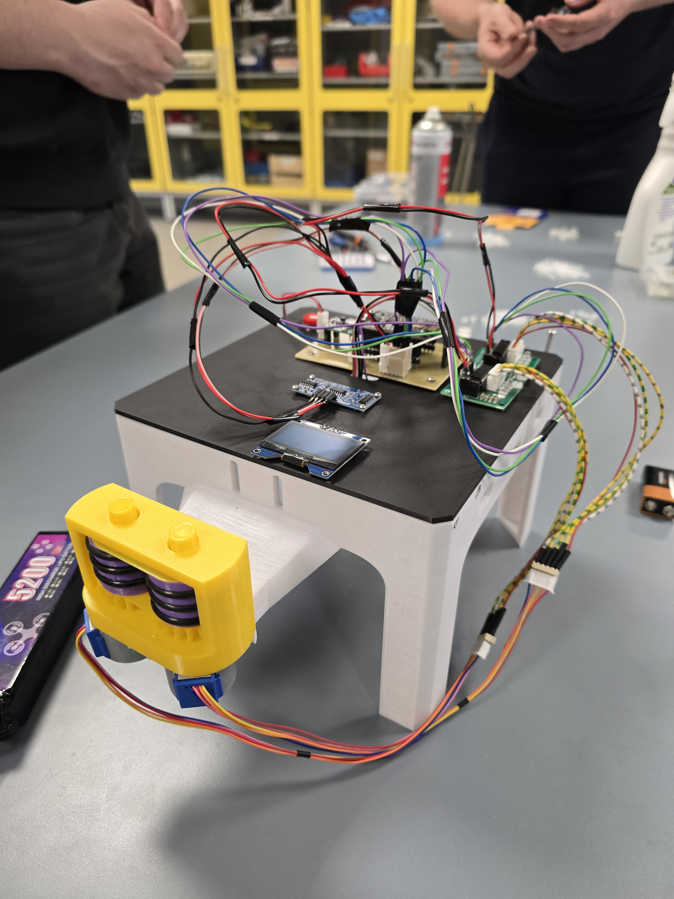
[picture p13: Overleaf/images/screenshots/bin_assembled.jpg]
Overleaf/images/screenshots/bin_assembled.jpg
